singerko/tekvica/obrazky/IMG_20261024_224829566_HDR.jpg

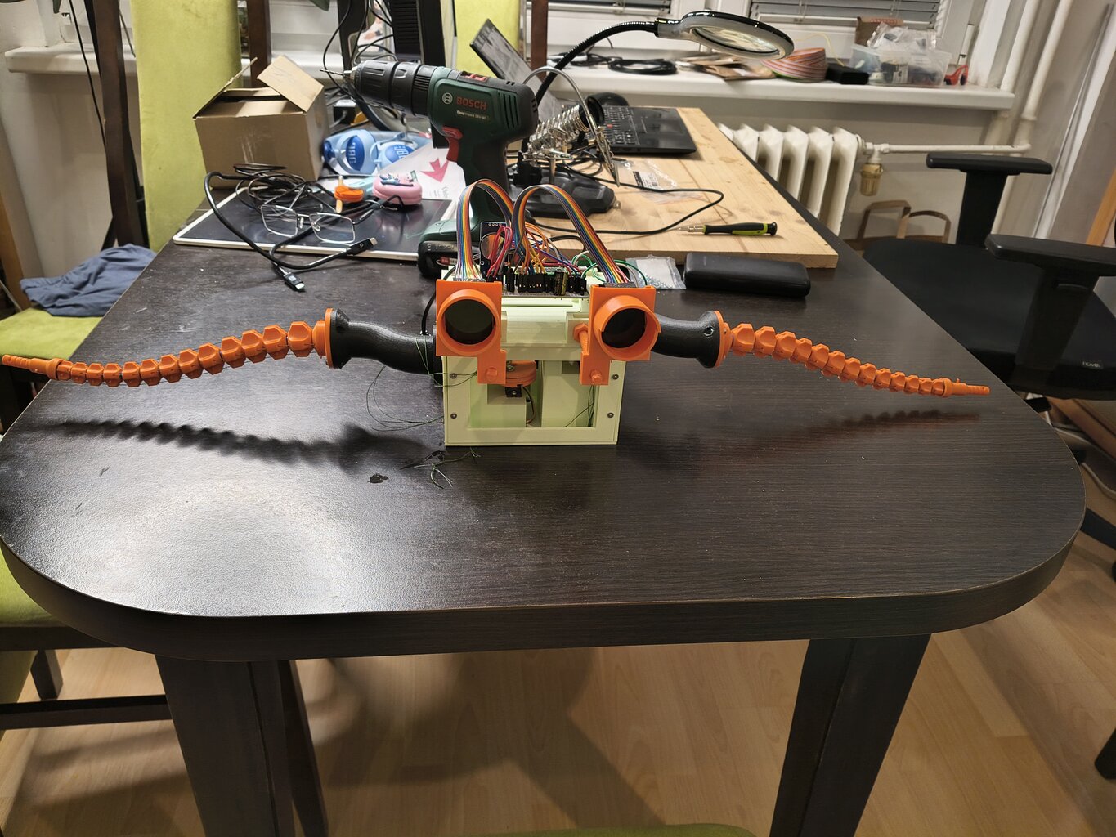
obrazky/IMG_20261024_224829566_HDR.jpg
