singerko/tekvica/obrazky/IMG_20261026_090807736_HDR.jpg

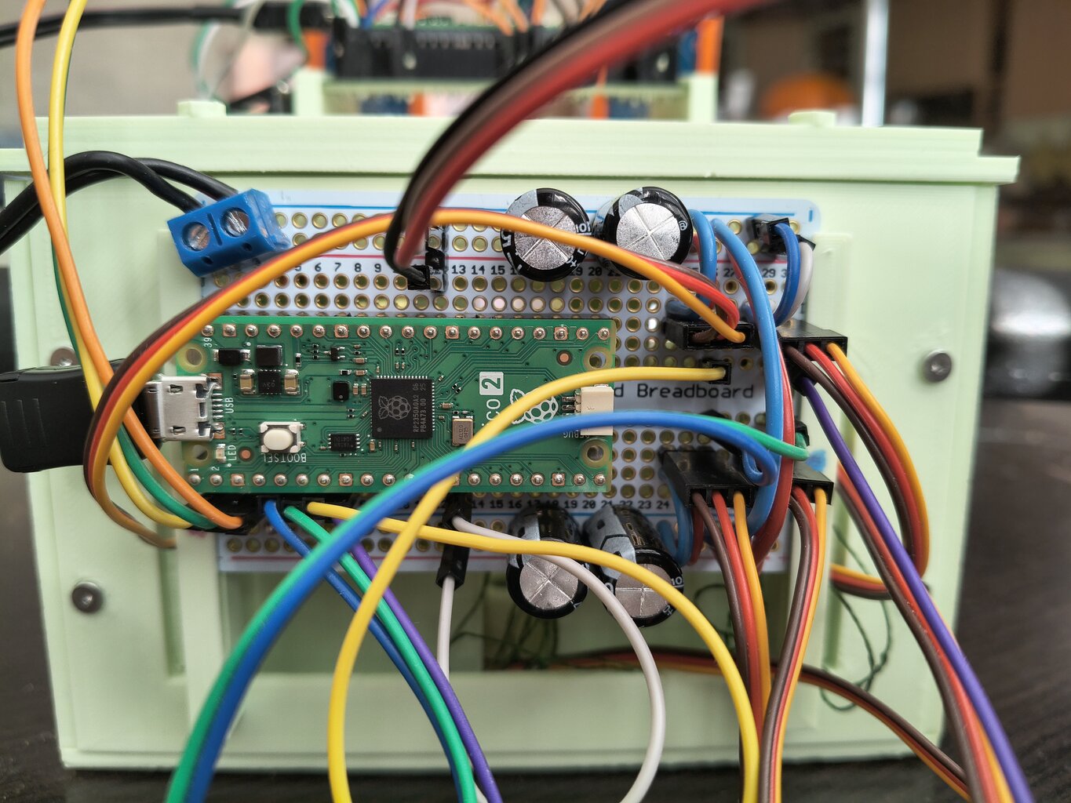
obrazky/IMG_20261026_090807736_HDR.jpg
