singerko/tekvica/obrazky/IMG_20261026_090816191_HDR.jpg

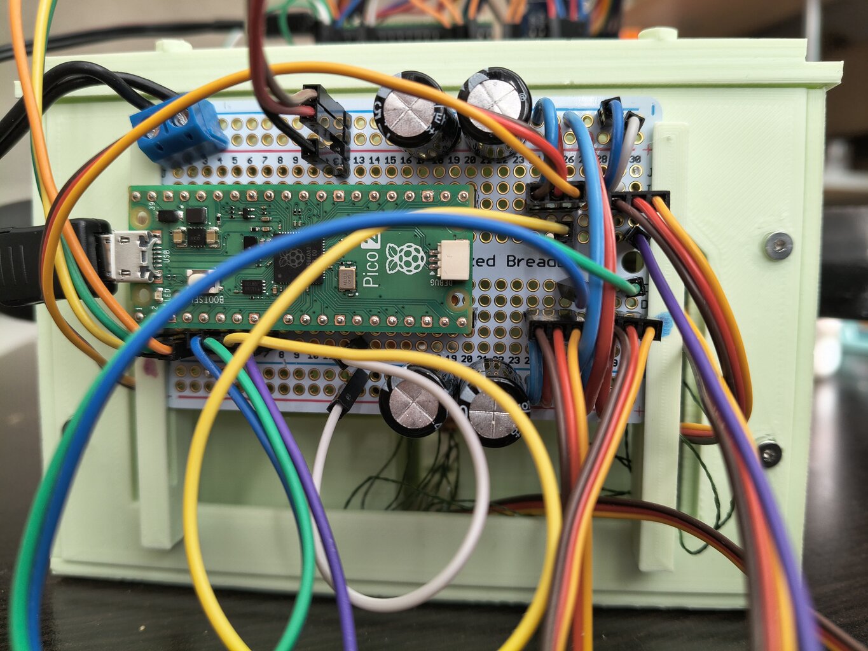
obrazky/IMG_20261026_090816191_HDR.jpg
