singerko/tekvica/obrazky/IMG_20261026_090822302_HDR.jpg

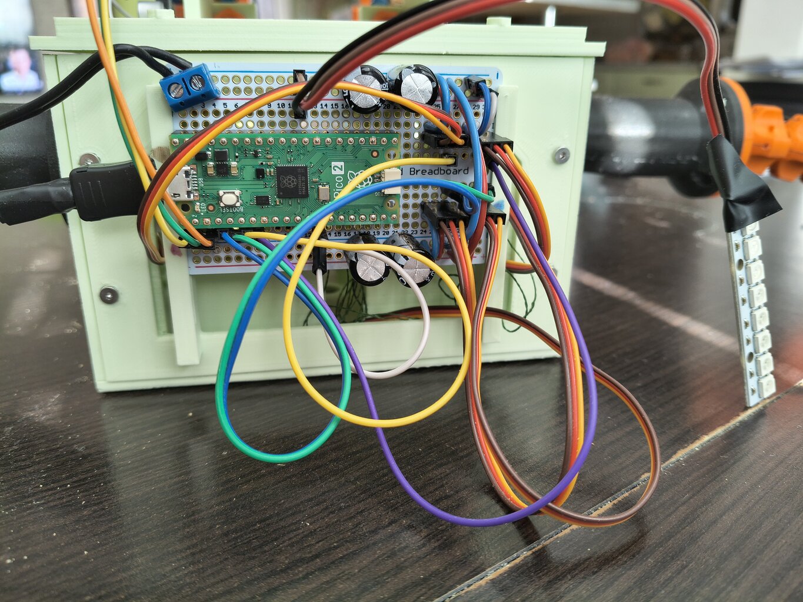
obrazky/IMG_20261026_090822302_HDR.jpg
