singerko/tekvica/obrazky/IMG_20261026_090901072_HDR.jpg

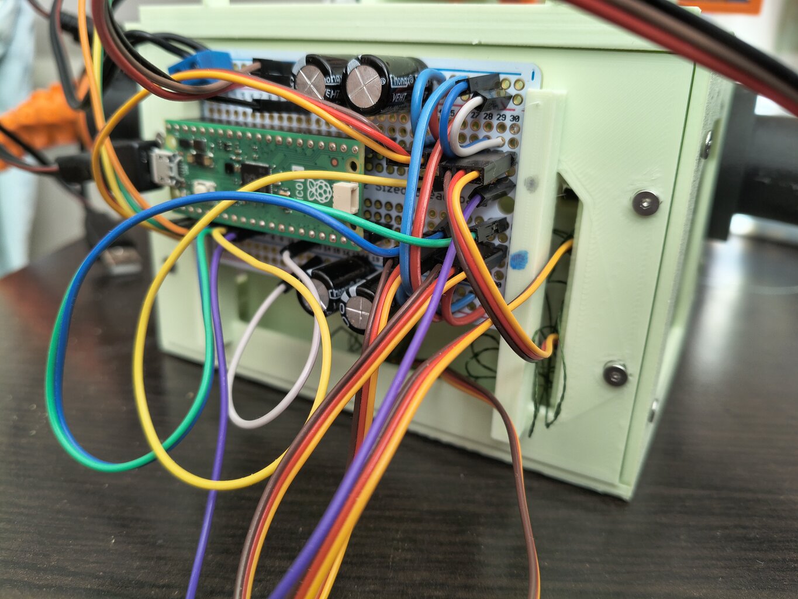
obrazky/IMG_20261026_090901072_HDR.jpg
