singerko/tekvica/obrazky/IMG_20261026_090922398_HDR.jpg

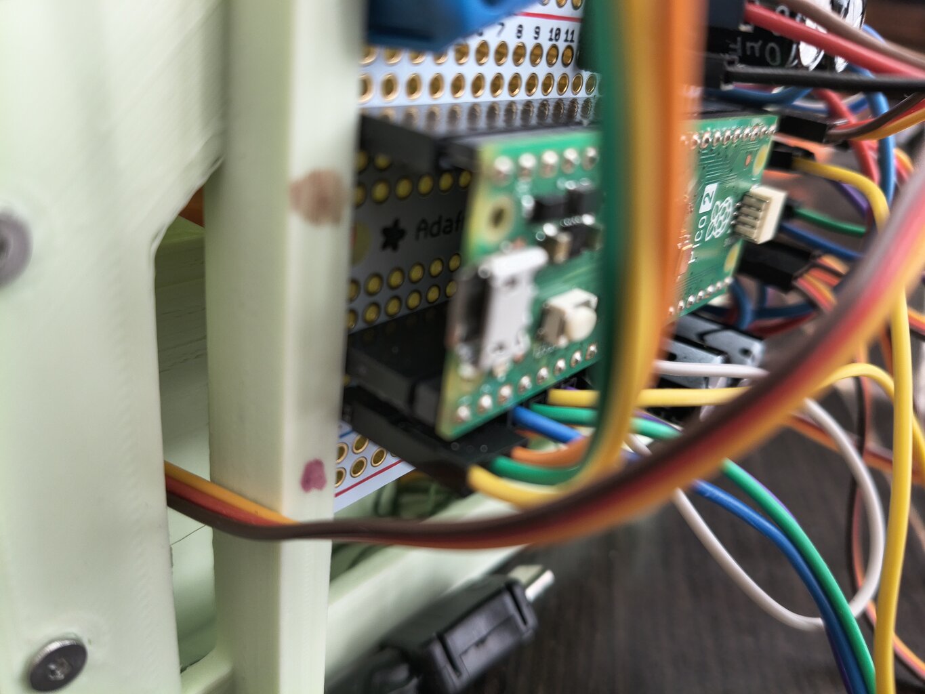
obrazky/IMG_20261026_090922398_HDR.jpg
