singerko/tekvica/obrazky/IMG_20261026_090934648_HDR.jpg

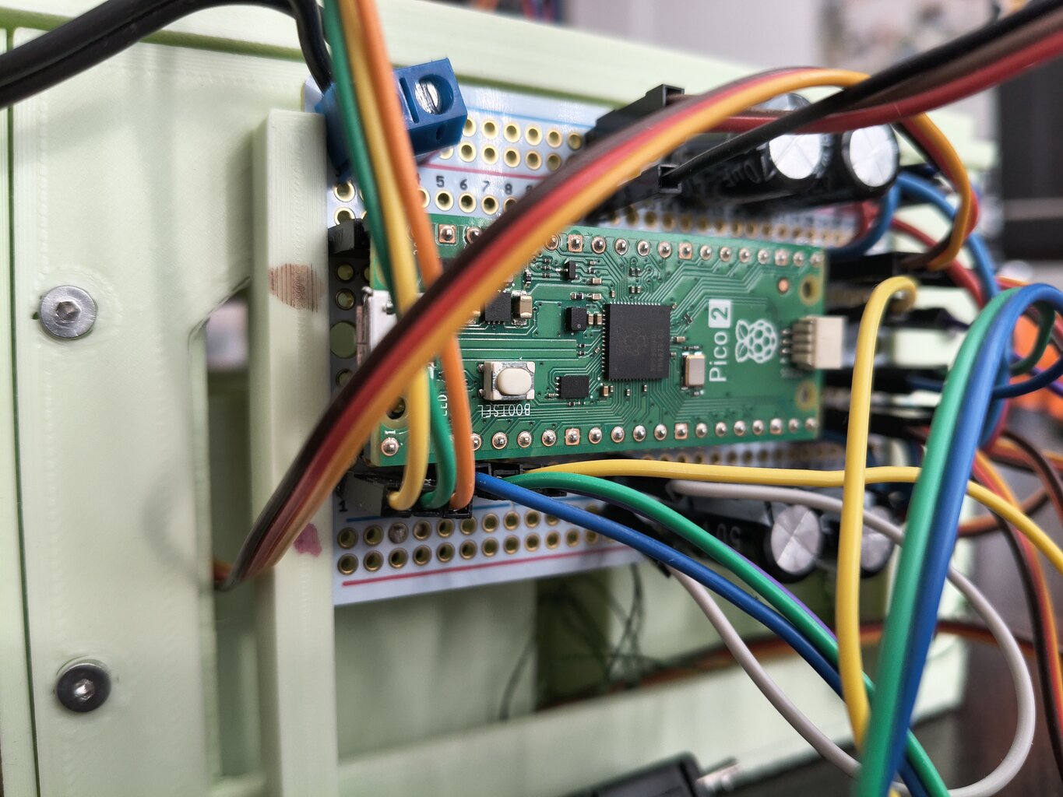
obrazky/IMG_20261026_090934648_HDR.jpg
