singerko/tekvica/obrazky/IMG_20261026_090941120_HDR.jpg

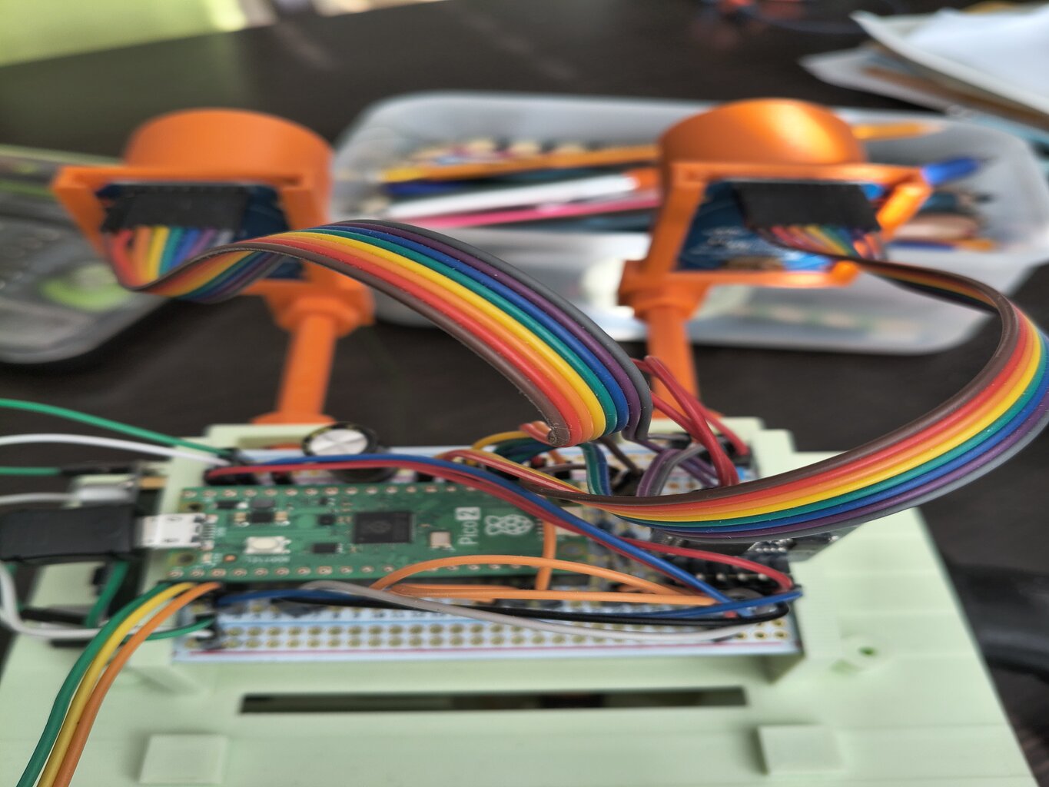
obrazky/IMG_20261026_090941120_HDR.jpg
