singerko/tekvica/obrazky/IMG_20261026_090947372_HDR.jpg

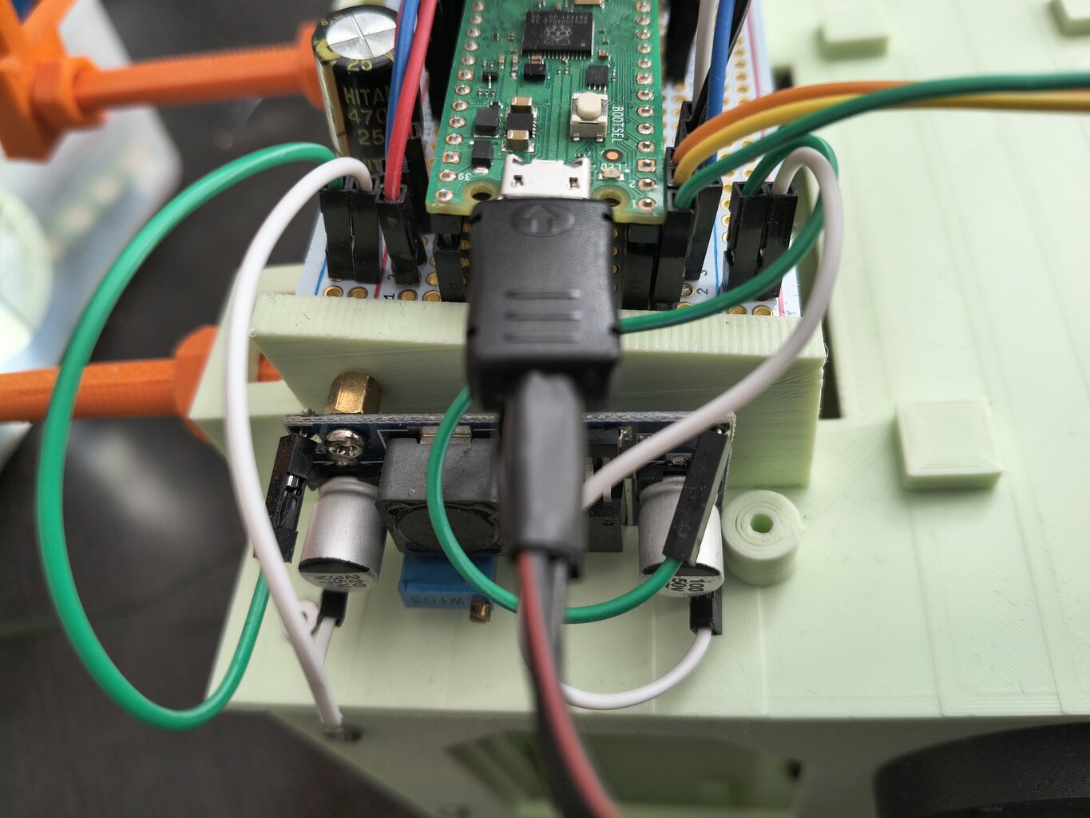
obrazky/IMG_20261026_090947372_HDR.jpg
