singerko/tekvica/obrazky/IMG_20261026_090951640_BURST000_COVER.jpg

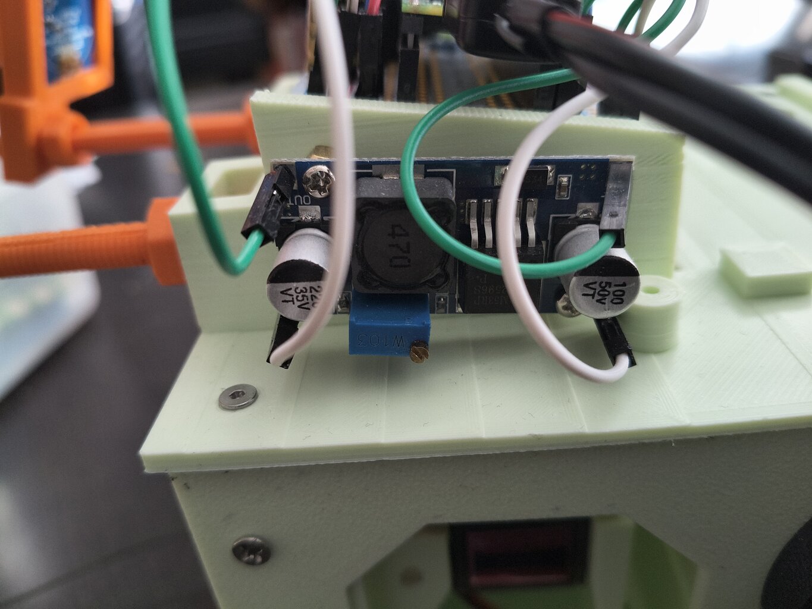
obrazky/IMG_20261026_090951640_BURST000_COVER.jpg
