singerko/tekvica/obrazky/IMG_20261026_090953784_HDR.jpg

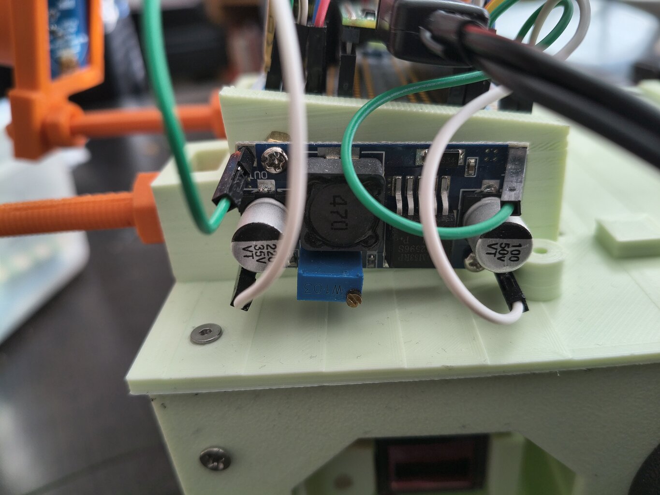
obrazky/IMG_20261026_090953784_HDR.jpg
