singerko/tekvica/obrazky/IMG_20261026_091058572_HDR.jpg

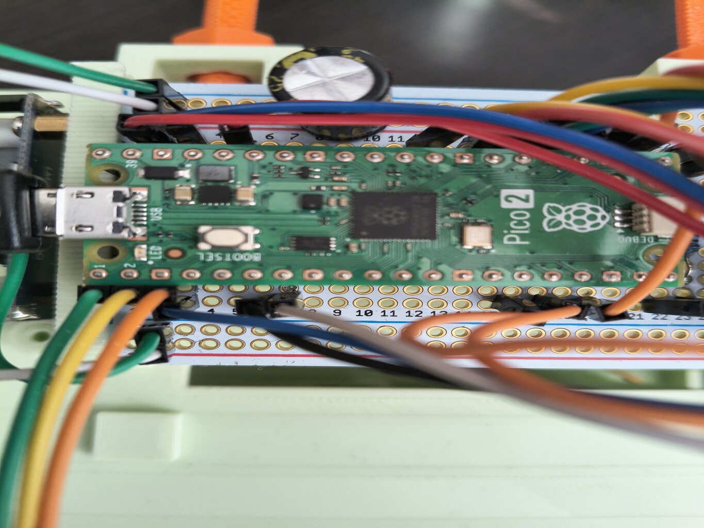
obrazky/IMG_20261026_091058572_HDR.jpg
