singerko/tekvica/obrazky/IMG_20261026_091106871_HDR.jpg

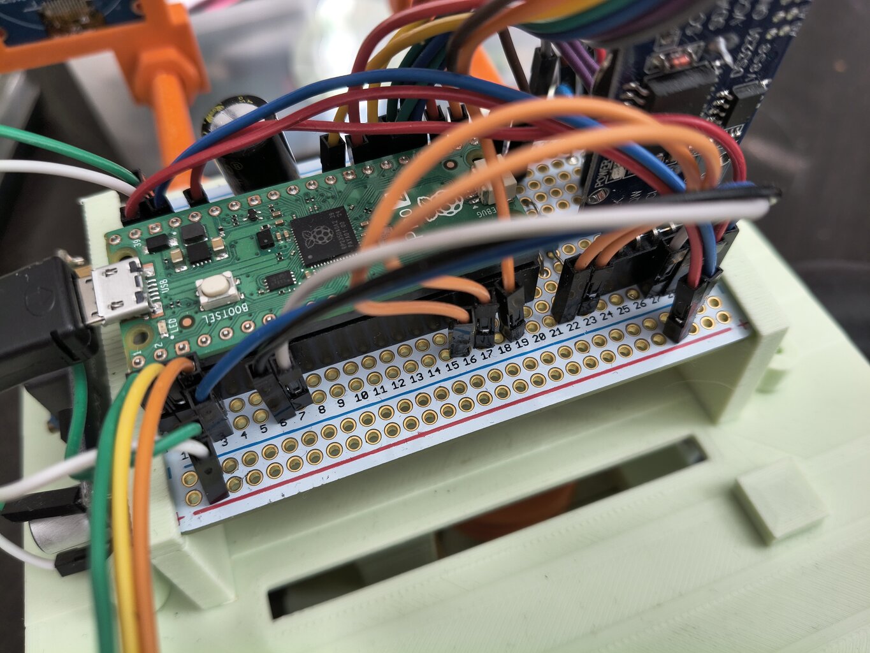
obrazky/IMG_20261026_091106871_HDR.jpg
