singerko/tekvica/obrazky/IMG_20261026_091112199_HDR.jpg

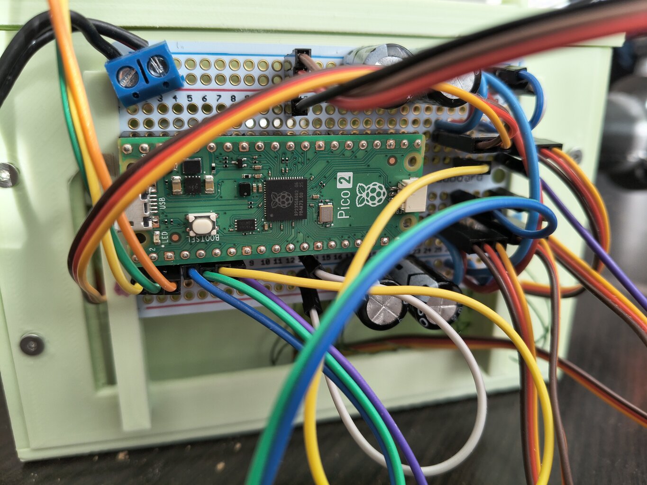
obrazky/IMG_20261026_091112199_HDR.jpg
