singerko/tekvica/obrazky/IMG_20261026_091117849_HDR.jpg

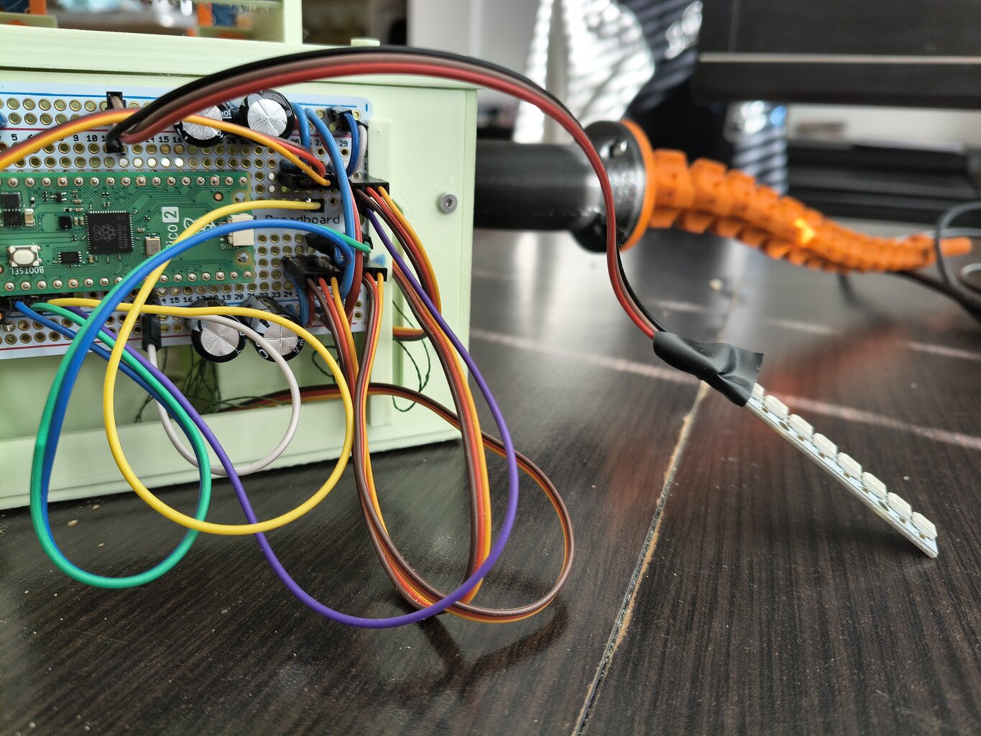
obrazky/IMG_20261026_091117849_HDR.jpg
