singerko/tekvica/zapojenie/prepojenie_pico.png

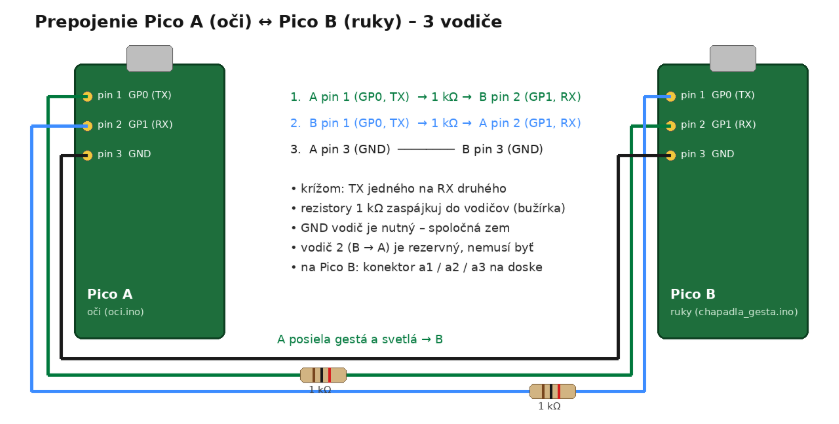
zapojenie/prepojenie_pico.png
