singerko/tekvica/stl/16_odtokovy_stlpik_1x.stl

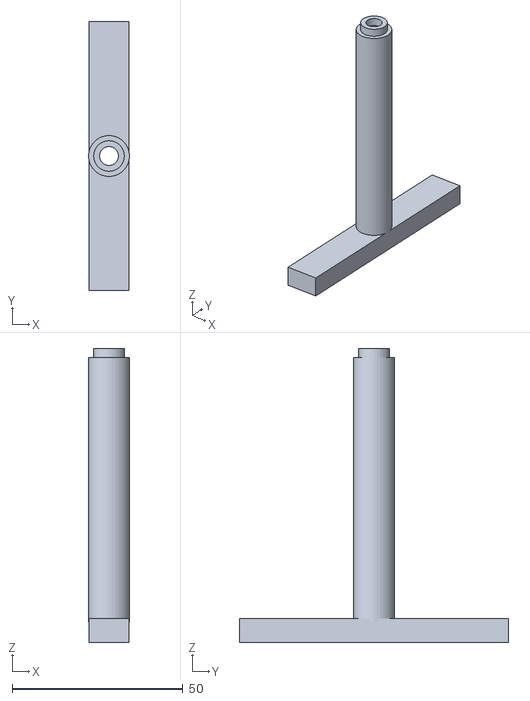
[picture p29: CAD file, 2026-10-27]
stl/16_odtokovy_stlpik_1x.stl
12.0 x 78.8 x 86.2
