singerko/tekvica/stl/03c_medzikus_vyoseny_S_30mm_tlacit_2x.stl

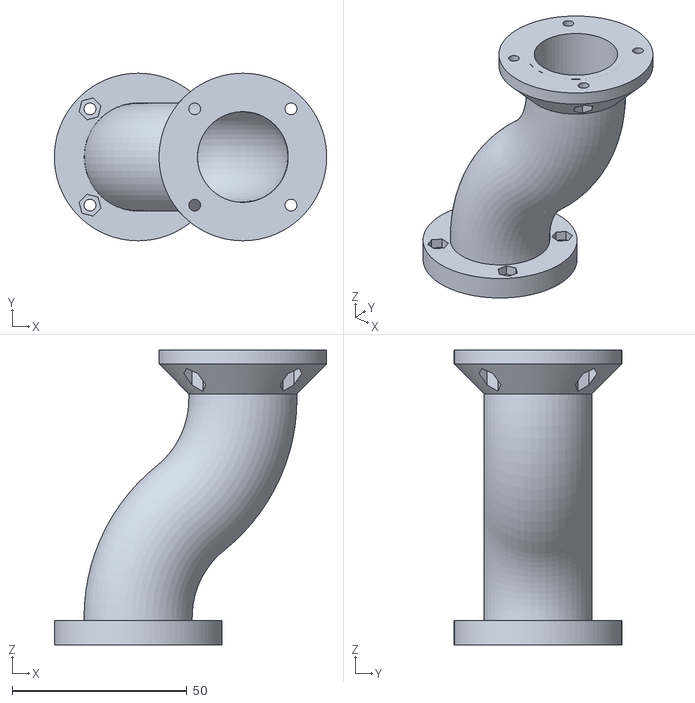
[picture p30: CAD file, 2026-10-27]
stl/03c_medzikus_vyoseny_S_30mm_tlacit_2x.stl
78.0 x 48.0 x 84.5
