singerko/tekvica/stl/07b_krabica_zadna_stena_s_listami_na_pico_1x.stl

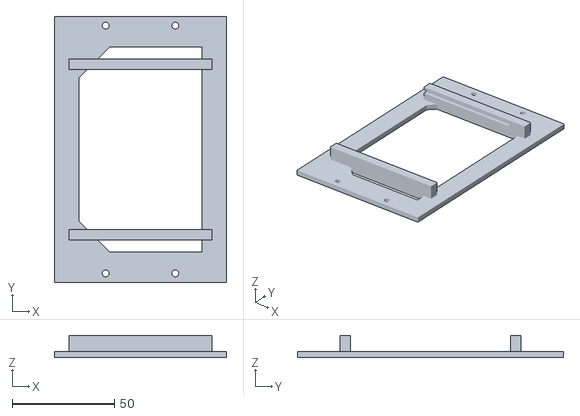
[picture p31: CAD file, 2026-10-27]
stl/07b_krabica_zadna_stena_s_listami_na_pico_1x.stl
84.0 x 130.0 x 10.8
