singerko/tekvica/stl/18_matica_M8_tlacena_tlacit_4x.stl

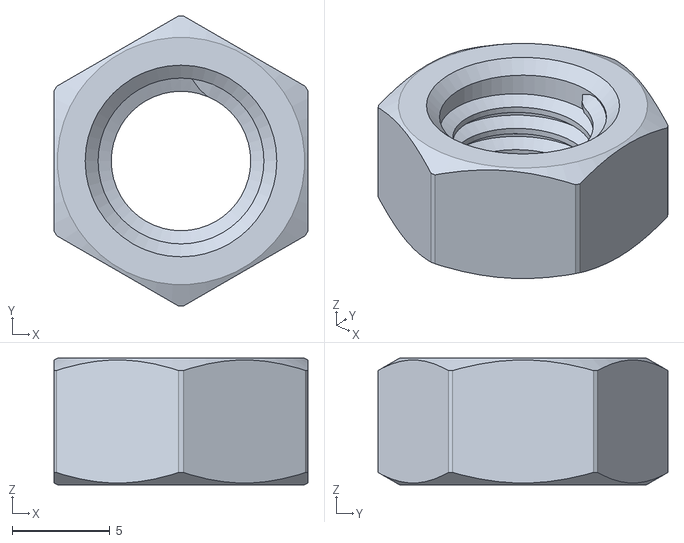
[picture p32: CAD file, 2026-10-27]
stl/18_matica_M8_tlacena_tlacit_4x.stl
13.0 x 14.9 x 6.50
