singerko/tekvica/stl/04_kladka_tlacit_4x.stl

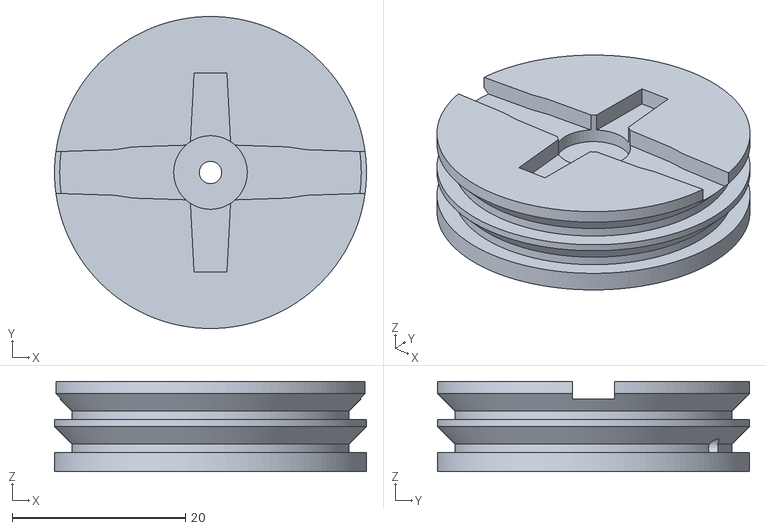
[picture p33: CAD file, 2026-10-27]
stl/04_kladka_tlacit_4x.stl
36.0 x 36.0 x 10.4
