singerko/tekvica/stl/06_krabica_stena_s_portom_tlacit_2x.stl

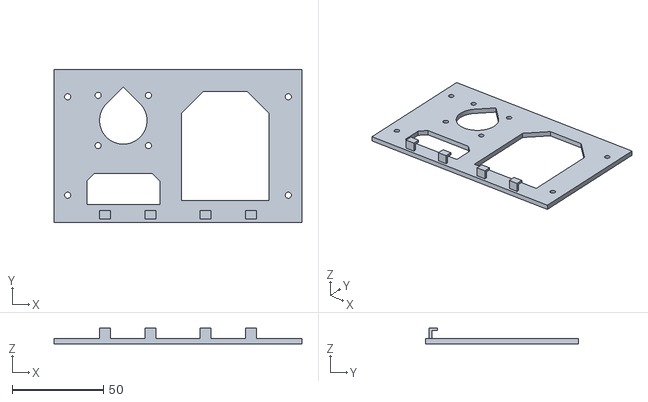
[picture p34: CAD file, 2026-10-27]
stl/06_krabica_stena_s_portom_tlacit_2x.stl
136.0 x 84.0 x 8.60
