singerko/tekvica/stl/13_oko_lave_tlaceny_zavit_1x.stl

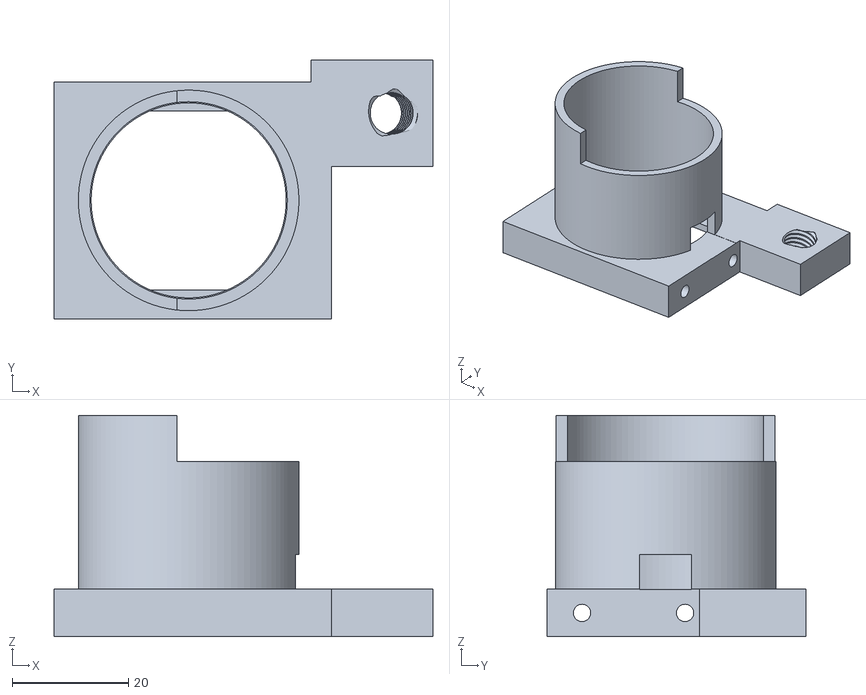
[picture p35: CAD file, 2026-10-27]
stl/13_oko_lave_tlaceny_zavit_1x.stl
65.3 x 44.5 x 38.1
