singerko/tekvica/stl/14_veko_s_nadstavcom_oci_a_powerbanka_1x.stl

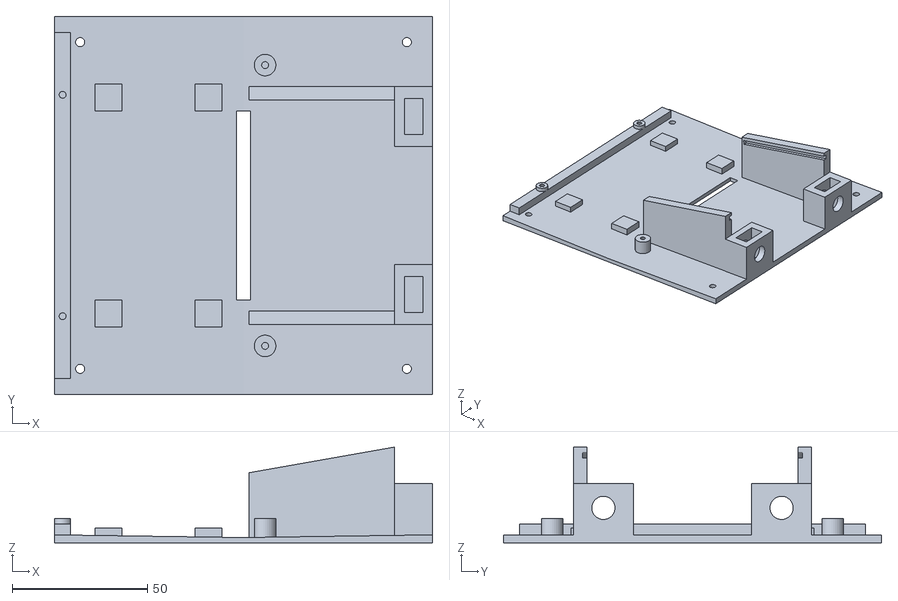
[picture p36: CAD file, 2026-10-27]
stl/14_veko_s_nadstavcom_oci_a_powerbanka_1x.stl
140.0 x 140.0 x 35.5
