singerko/tekvica/stl/04t_test_vybrania_hornu.stl

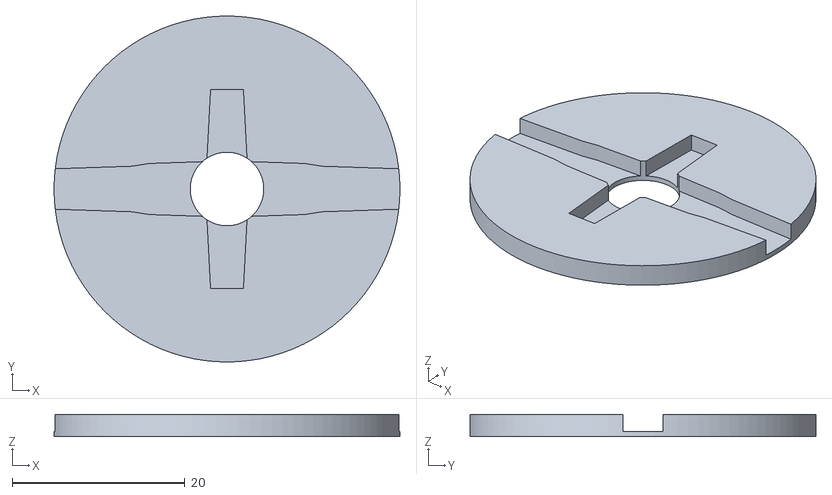
[picture p37: CAD file, 2026-10-27]
stl/04t_test_vybrania_hornu.stl
40.0 x 40.0 x 2.60
