singerko/tekvica/stl/07_krabica_predna_bocna_stena_1x.stl

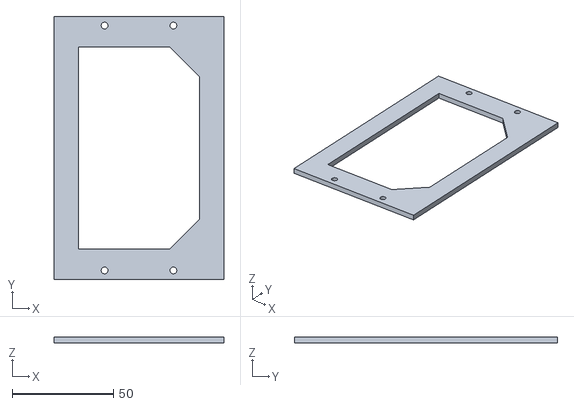
[picture p38: CAD file, 2026-10-27]
stl/07_krabica_predna_bocna_stena_1x.stl
84.0 x 130.0 x 3.00
