singerko/tekvica/stl/03b_medzikus_zahnuty_40st_tlacit_2x.stl

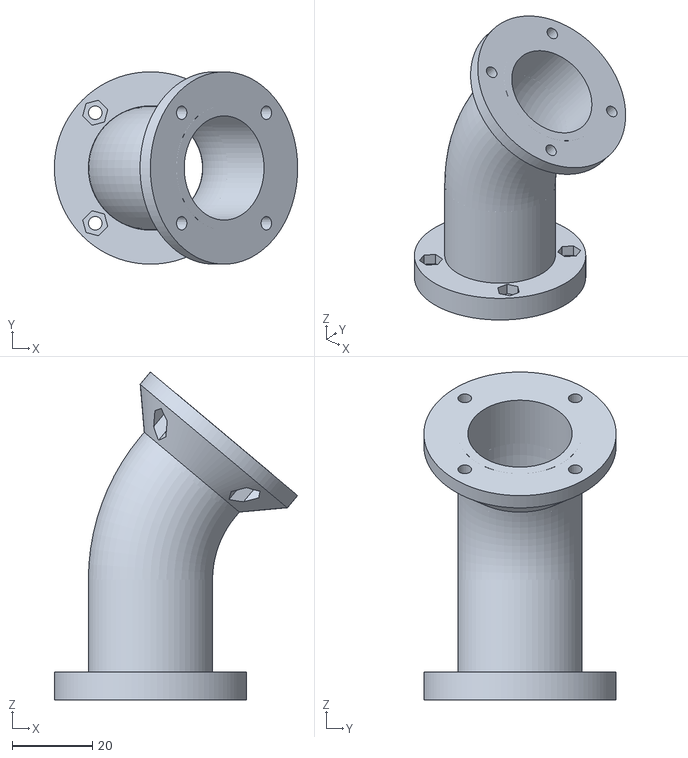
[picture p39: CAD file, 2026-10-27]
stl/03b_medzikus_zahnuty_40st_tlacit_2x.stl
60.7 x 48.0 x 81.9
