singerko/tekvica/stl/17_tyc_oci_M8_tlacit_2x.stl

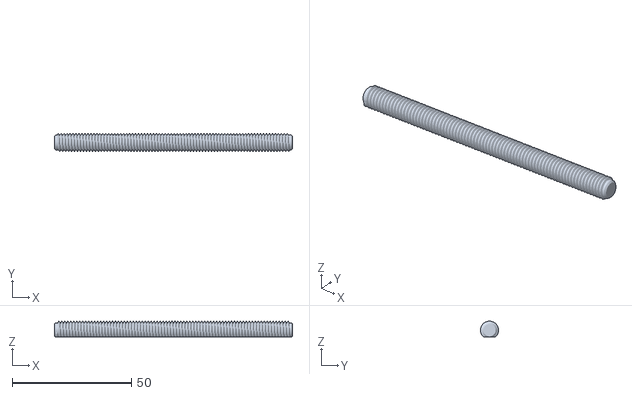
[picture p40: CAD file, 2026-10-27]
stl/17_tyc_oci_M8_tlacit_2x.stl
100.0 x 7.60 x 6.60
