singerko/tekvica/stl/02_zakladna_chapadla_tlacit_2x.stl

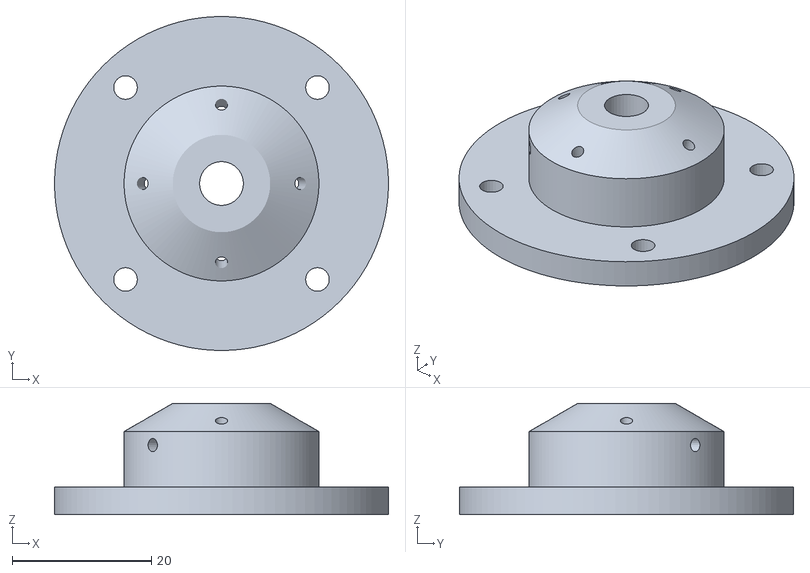
[picture p41: CAD file, 2026-10-27]
stl/02_zakladna_chapadla_tlacit_2x.stl
48.0 x 48.0 x 16.0
