singerko/tekvica/stl/09_test_drziak_serva_1x.stl

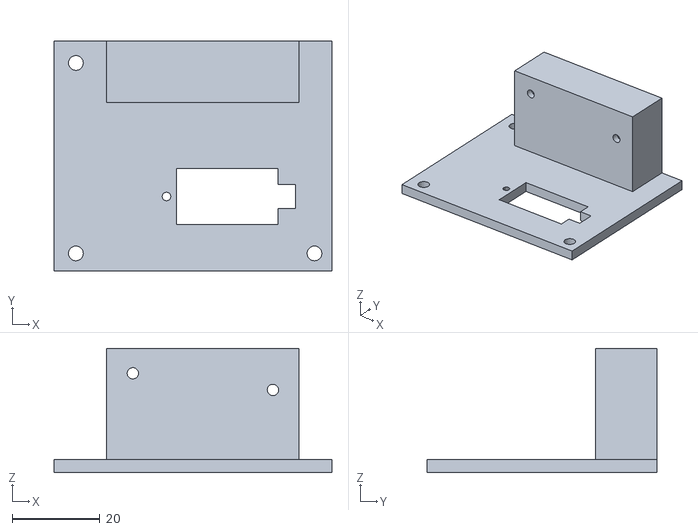
[picture p42: CAD file, 2026-10-27]
stl/09_test_drziak_serva_1x.stl
63.5 x 52.5 x 28.4
