singerko/tekvica/stl/01_chapadlo_12_segmentov_a_palicka_tlacit_2x.stl

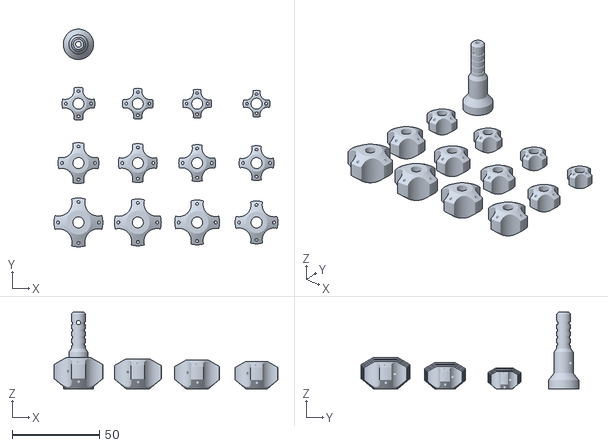
[picture p43: CAD file, 2026-10-27]
stl/01_chapadlo_12_segmentov_a_palicka_tlacit_2x.stl
128.3 x 124.7 x 44.0
