singerko/tekvica/stl/03_medzikus_rovny_30mm_tlacit_2x.stl

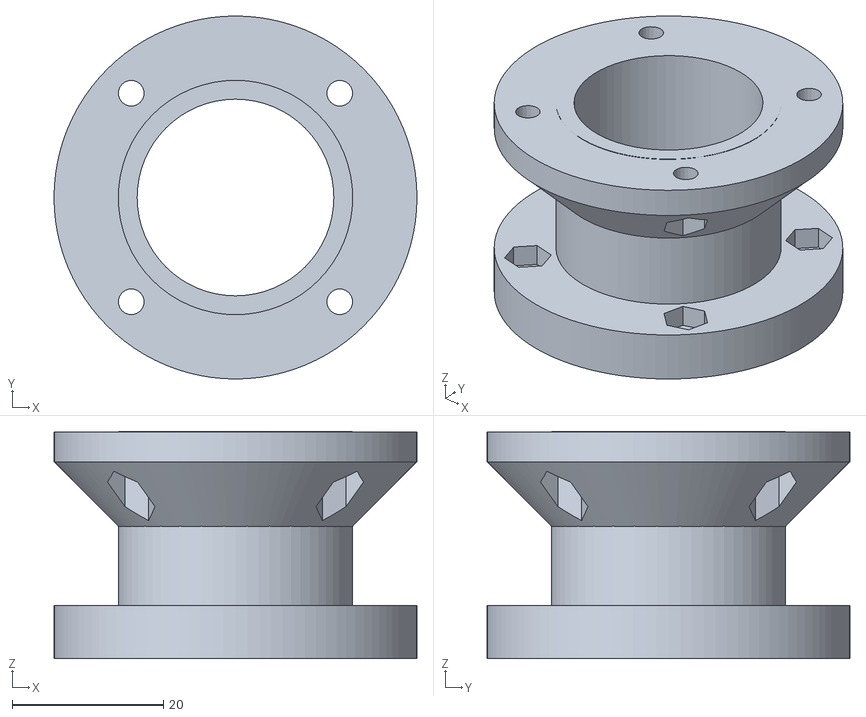
[picture p44: CAD file, 2026-10-27]
stl/03_medzikus_rovny_30mm_tlacit_2x.stl
48.0 x 48.0 x 30.1
