singerko/tekvica/stl/12_spicka_namiesto_palicky_ALTERNATIVA_2x.stl

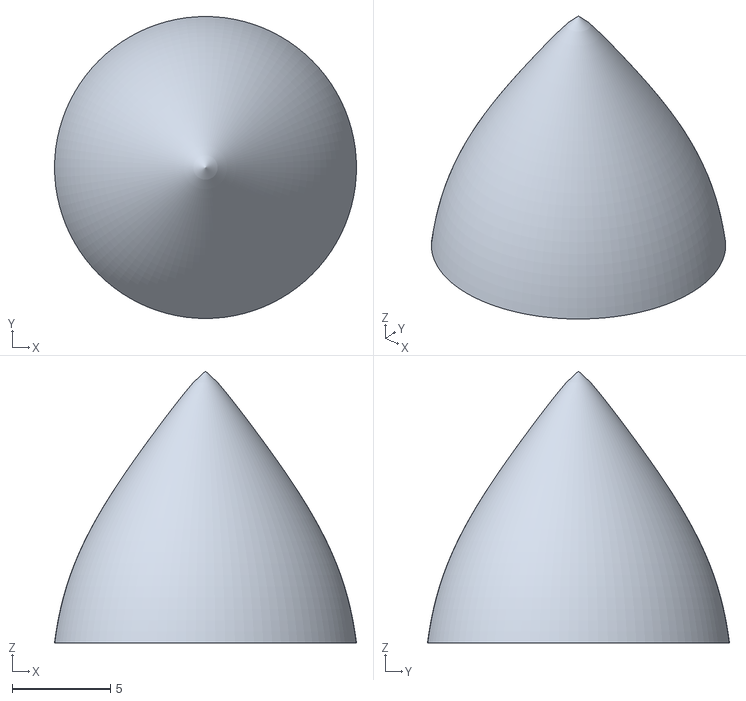
[picture p45: CAD file, 2026-10-27]
stl/12_spicka_namiesto_palicky_ALTERNATIVA_2x.stl
15.4 x 15.4 x 13.9
