singerko/tekvica/stl/05_krabica_dno_1x.stl

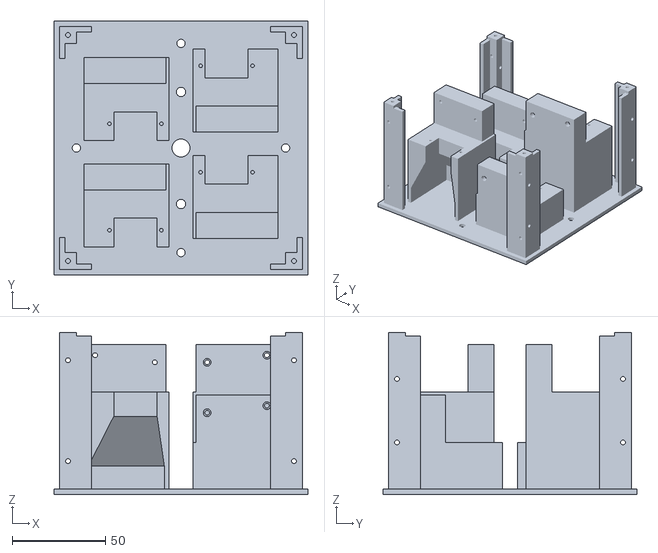
[picture p46: CAD file, 2026-10-27]
stl/05_krabica_dno_1x.stl
136.0 x 136.0 x 87.0
