singerko/tekvica/(list of files, cad)

Other CAD files:
stl/13b_oko_prave_tlaceny_zavit_1x.stl
